munzmo/airtrack_micropi/docs/01_HW/01_Manuals/ESP32_pin_assign.pdf

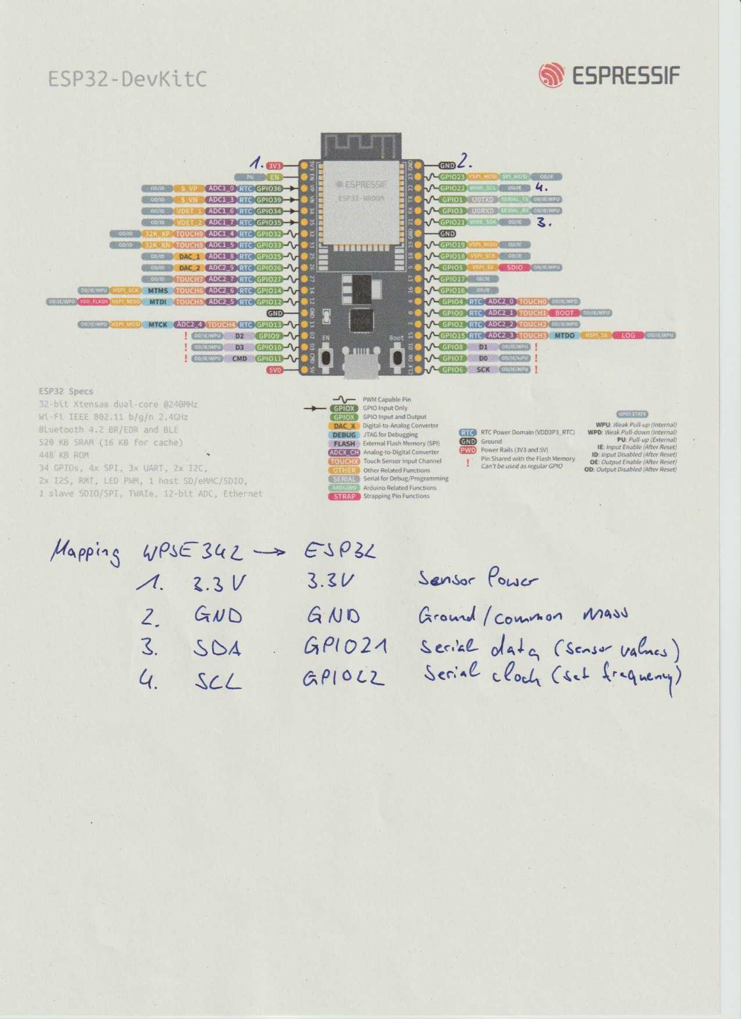
[picture p1: page 1]
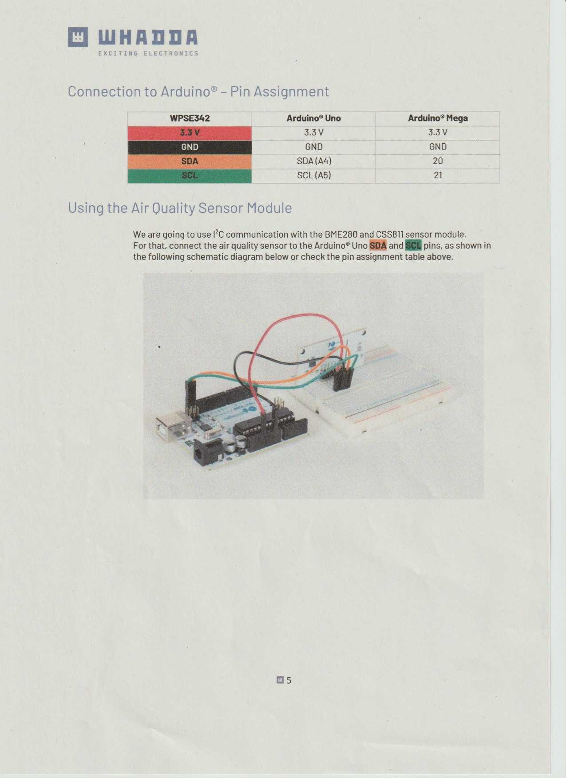
[picture p2: page 2]
