munzmo/airtrack_micropi/ccs811_flash.py

# ccs811_flash.py
# Flashes CCS811 sensor to firmware v2.0.1 via I2C on MicroPython (ESP32).
# Run once via: mpremote connect /dev/ttyUSB0 run ccs811_flash.py
#
# DISCLAIMER: Flashing firmware carries the risk of bricking your CCS811.
# Risk is low (only application firmware, bootloader stays intact).
# v2.0.1 is intended for already burned-in sensors (burn-in compensation disabled).
#
# After successful flash: delete ccs811_baseline.json and restart main.py.

from machine import Pin, I2C
import time

SDA      = 21
SCL      = 22
CCS_ADDR = 0x5B

REG_STATUS     = 0x00
REG_SW_RESET   = 0xFF
REG_APP_ERASE  = 0xF1
REG_APP_DATA   = 0xF2
REG_APP_VERIFY = 0xF3

# CCS811 firmware v2.0.1 binary (5112 bytes)
FW = bytes.fromhex(
    "704ef41e2da78d4ffc88804902dc1710b00e5a648c35b88981d4acb38fa3529b"
    "8a8fa0a47e19763eb249b952e5f61e693cb1445f91a2dcd22d36352e99d1441b"
    "0547c006e4bc914121256fb11e5e811ef6fa591dce74ed1517e7d02dded46c72"
    "19db890e05763d9eb6daf90854b00d4a9f2cdac7ceda09dd3841f995cc91828f"
    "99c3fb14cd77629680654cfbe269acd0b30f3037b62ec7394408e186eae45d21"
    "57a0e6c98b287f5341b8ae1e4b32d5ed2904835c16b5f83df5e4a8e2f0c90890"
    "e4ab0360cbf8ca2ff3505d9d2830323b596a70f10077b3a2d87bb3a7d8711cec"
    "320ce5c7645aa97b72d51631e7d971d9bd425c9167c251bed85a3c842409dcc2"
    "dbb98e63c38c94d4d0fef6c2b22cecd2565265452424325199d2808702ff713b"
    "9b31a787ad771e17253b3a599e2fc5ffdc8e64a85ac0f840e609ad030bf4e6e3"
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
    "7aa6cdf4eaef8a59a558d5649a961a9e47f87ac22f283dbf7583cf91e7e0b4ea"
    "7bbaa09c93c262aa96aa1798ccebb2d6edc36265c590f55f964ec1377519ea96"
    "3cf19f0cbb012fb0ecb75a5d81913837d2c32ec1dba7df49bb56ea21114ccaa2"
    "8ca881f82ecb1edd09719da41a4c21dabca670d4225119ea0167bb0126fd64cd"
    "1d32b4fe3e73a426899a7758841acd02fa7b3036a0717e13139b58fcaa7d3327"
    "3c73a69308aaeae480bb5a3d3a7c0f9c302fd402cb40ec91"
)

i2c = I2C(0, sda=Pin(SDA), scl=Pin(SCL), freq=100_000)

def _r8(reg):
    return i2c.readfrom_mem(CCS_ADDR, reg, 1)[0]

def _w(reg, data):
    i2c.writeto_mem(CCS_ADDR, reg, bytes(data))

def _status(st):
    return "fw_mode=%d app_valid=%d error=%d" % (
        (st >> 7) & 1, (st >> 4) & 1, st & 1)

print("CCS811 firmware flash — v2.0.1")
print("FW size: %d bytes, %d chunks" % (len(FW), len(FW) // 8))

# Check I2C
addrs = i2c.scan()
print("I2C scan:", [hex(a) for a in addrs])
if CCS_ADDR not in addrs:
    raise Exception("CCS811 not found at 0x%02x" % CCS_ADDR)

# Step 1: Software reset → boot mode
print("\n[1/5] Software reset...")
_w(REG_SW_RESET, [0x11, 0xE5, 0x72, 0x8A])
time.sleep_ms(100)
st = _r8(REG_STATUS)
print("      status: 0x%02x (%s)" % (st, _status(st)))
if st & 0x80:
    raise Exception("Sensor in app mode after reset — cannot flash")

# Step 2: Erase application firmware
print("[2/5] Erasing application firmware (~500ms)...")
_w(REG_APP_ERASE, [0xE7, 0xA7, 0xE6, 0x09])
time.sleep_ms(500)
st = _r8(REG_STATUS)
print("      status: 0x%02x (%s)" % (st, _status(st)))

# Step 3: Write firmware in 8-byte chunks
chunks = len(FW) // 8
print("[3/5] Writing %d chunks (%d bytes)..." % (chunks, len(FW)))
for i in range(chunks):
    _w(REG_APP_DATA, list(FW[i * 8:(i + 1) * 8]))
    time.sleep_ms(50)
    if i % 80 == 0:
        print("      chunk %d/%d" % (i, chunks))
st = _r8(REG_STATUS)
print("      done — status: 0x%02x (%s)" % (st, _status(st)))

# Step 4: Verify firmware
print("[4/5] Verifying firmware (~70ms)...")
i2c.writeto(CCS_ADDR, bytes([REG_APP_VERIFY]))
time.sleep_ms(70)
st = _r8(REG_STATUS)
print("      status: 0x%02x (%s)" % (st, _status(st)))
if not (st & 0x10):
    raise Exception("app_valid not set after verify — FLASH FAILED")

# Step 5: Final reset + confirm
print("[5/5] Final reset and confirmation...")
_w(REG_SW_RESET, [0x11, 0xE5, 0x72, 0x8A])
time.sleep_ms(100)
st = _r8(REG_STATUS)
print("      status: 0x%02x (%s)" % (st, _status(st)))
fw_mode   = (st & 0x80) != 0
app_valid = (st & 0x10) != 0
if (not fw_mode) and app_valid:
    print("\n*** SUCCESS: CCS811 flashed to firmware v2.0.1 ***")
    print("Next steps:")
    print("  1. mpremote connect /dev/ttyUSB0 rm :ccs811_baseline.json")
    print("  2. mpremote connect /dev/ttyUSB0 reset")
else:
    raise Exception("Unexpected status after flash: 0x%02x" % st)
