munzmo/airtrack_micropi/(commit log)

2026-01-23 Add pin assign overview
2026-01-26 Update flexible Sensor Extension Readme. incl. UI
2026-01-30 Update final construct with 3 sensors
2026-02-07 Update UI - logic current kpi charts
2026-02-10 CCS811 sensor baseline implementing
2026-02-27 Push untested changes regarding active cooling implementation - what should go wrong?
    [main.py]
2026-02-27 Update UI and correct 5V Pinout manual
2026-03-13 implementing exension hook and new sensor logic for ens160_bme280
2026-03-15 ccs811 tuning; ignore first 20min for burn in time
    [main.py, wpse342.py]
2026-03-27 new sensor ens160_bme280 - activation and set in production
2026-03-30 BME280 self heating problem solution
    [main.py, wpse342.py]
2026-04-04 Reducing fan to 0.25, Remove `& 0xFF00` mask
2026-06-12 BME280 low-noise profile: oversampling x2/x16/x16 + IIR filter
    [wpse342.py]
